aniket-shigwan/Custom_Latte_Panda_Carrier_board/LattePandaCustom/3D_board_images/top1.png

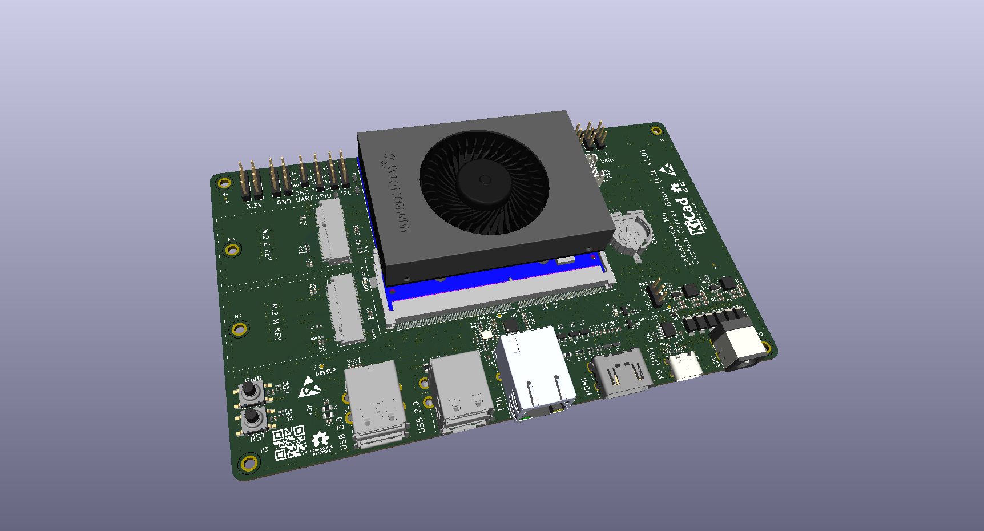
LattePandaCustom/3D_board_images/top1.png
