aniket-shigwan/Custom_Latte_Panda_Carrier_board/LattePandaCustom/3D_board_images/bottom.png

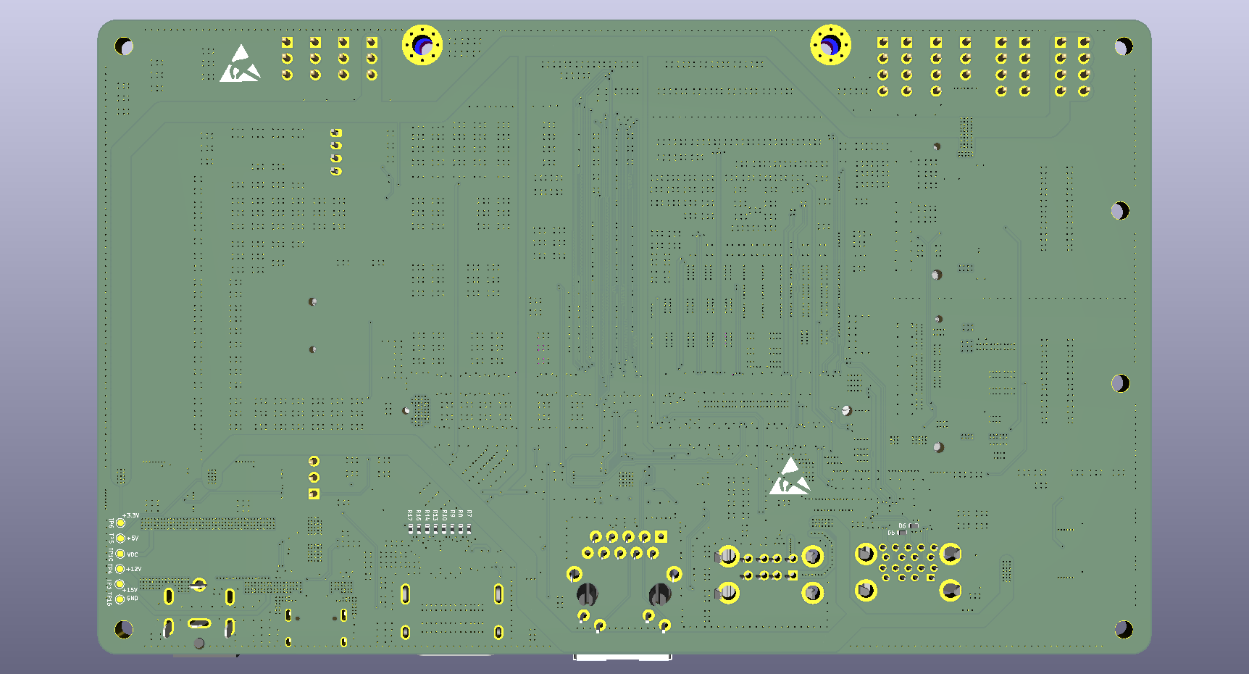
LattePandaCustom/3D_board_images/bottom.png
