aniket-shigwan/Custom_Latte_Panda_Carrier_board/LattePandaCustom/3D_board_images/connector.png

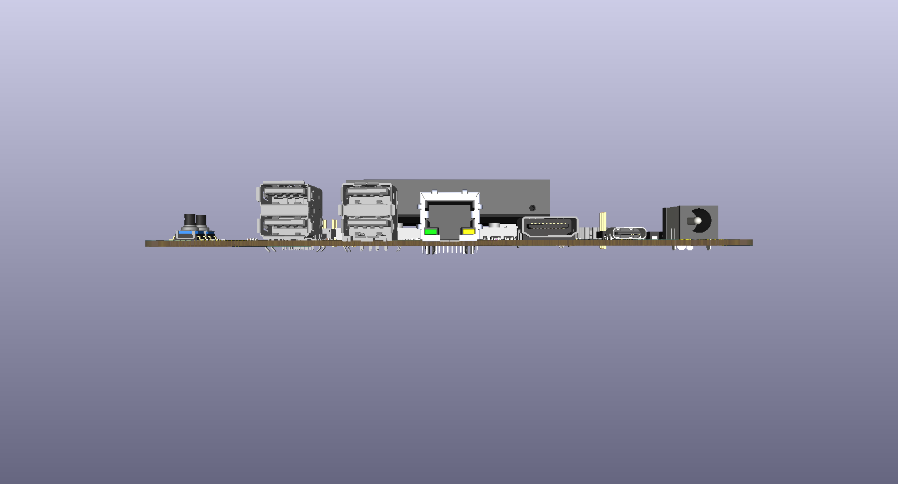
LattePandaCustom/3D_board_images/connector.png
