aniket-shigwan/Custom_Latte_Panda_Carrier_board/LattePandaCustom/PCB_images/HDMI differential.png

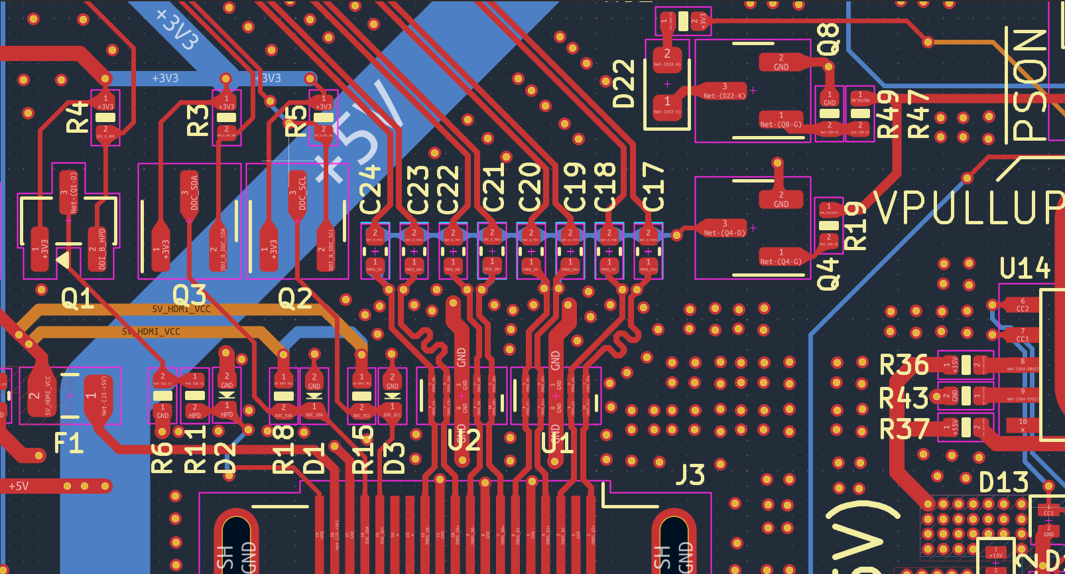
LattePandaCustom/PCB_images/HDMI differential.png
