aniket-shigwan/Custom_Latte_Panda_Carrier_board/LattePandaCustom/PCB_images/length_matching.png

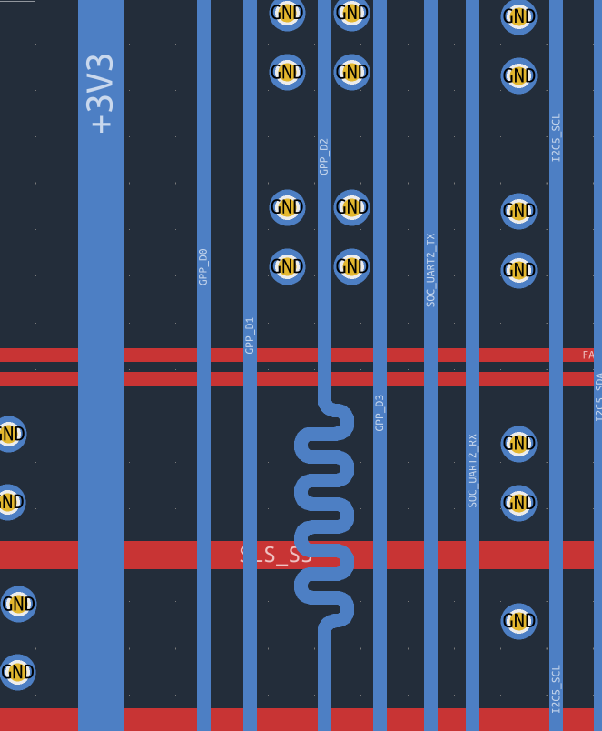
LattePandaCustom/PCB_images/length_matching.png
