aniket-shigwan/Custom_Latte_Panda_Carrier_board/LattePandaCustom/PCB_images/PCB.png

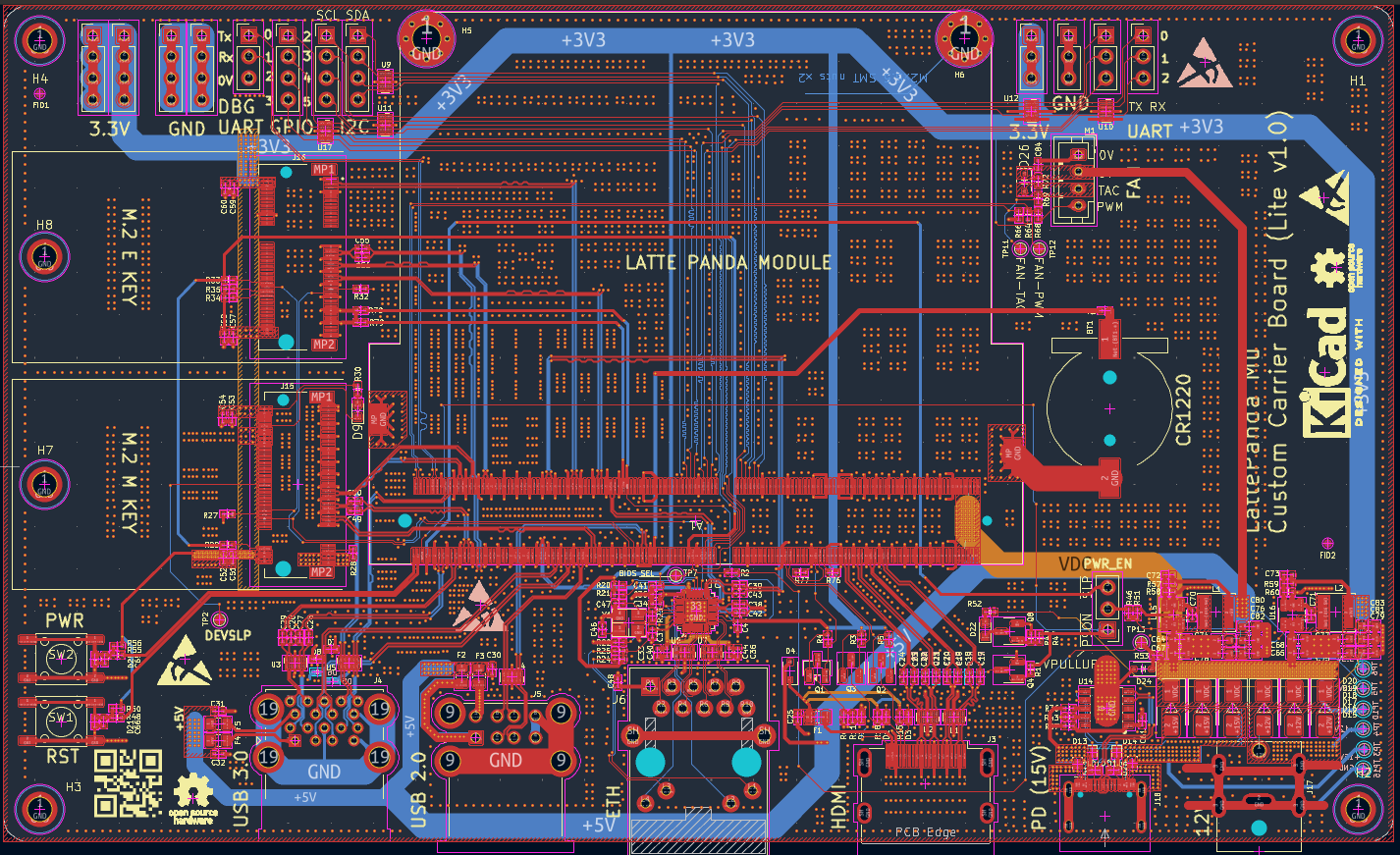
LattePandaCustom/PCB_images/PCB.png
