aniket-shigwan/Custom_Latte_Panda_Carrier_board/LattePandaCustom/PCB_images/USB_sskew.png

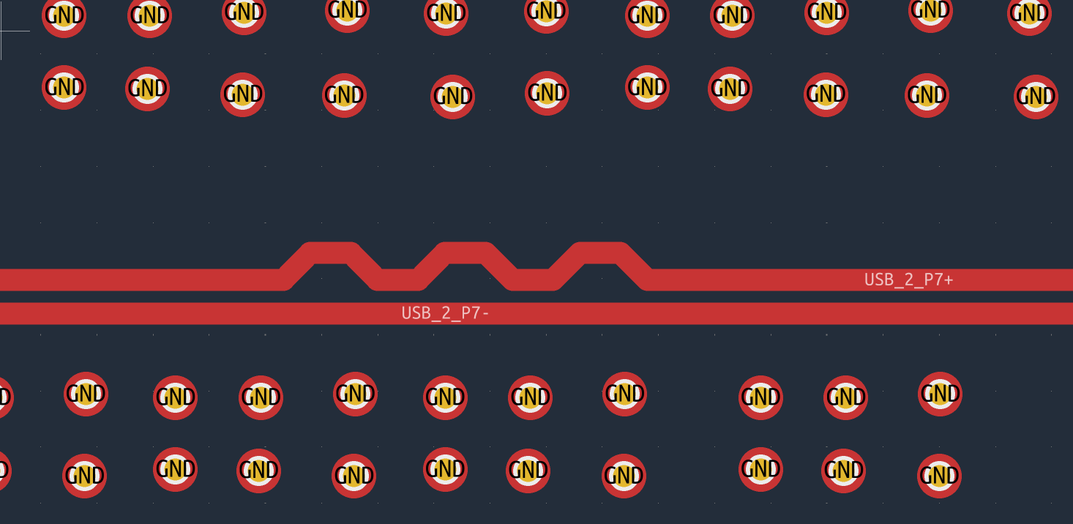
LattePandaCustom/PCB_images/USB_sskew.png
