aniket-shigwan/Custom_Latte_Panda_Carrier_board/(commit log)

2026-05-27 upload kicad pcb design files
    [LattePandaCustom.kicad_pcb, LattePandaCustom.kicad_sch, LattePandaModule.kicad_sch, ethernet.kicad_sch, fan.kicad_sch, gpio.kicad_sch, hdmi.kicad_sch, m2_e&m.kicad_sch]
2026-05-27 upload 3D images of the PCB
2026-05-28 added GND stitching vias to PCB and added 3D renders and PCB images
    [LattePandaCustom.kicad_pcb]
